jp3141/60Hz/60Hz.jpg

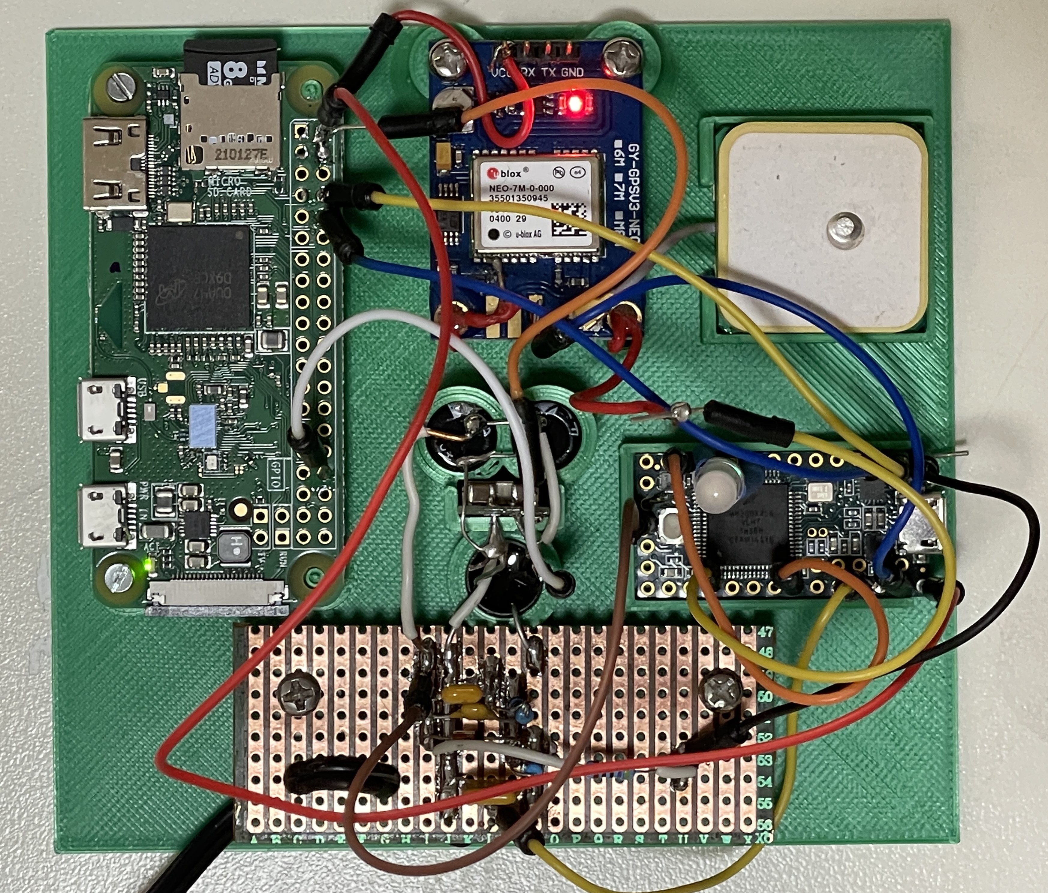
60Hz.jpg
