jp3141/60Hz/60 Hz Data 1 Month.png

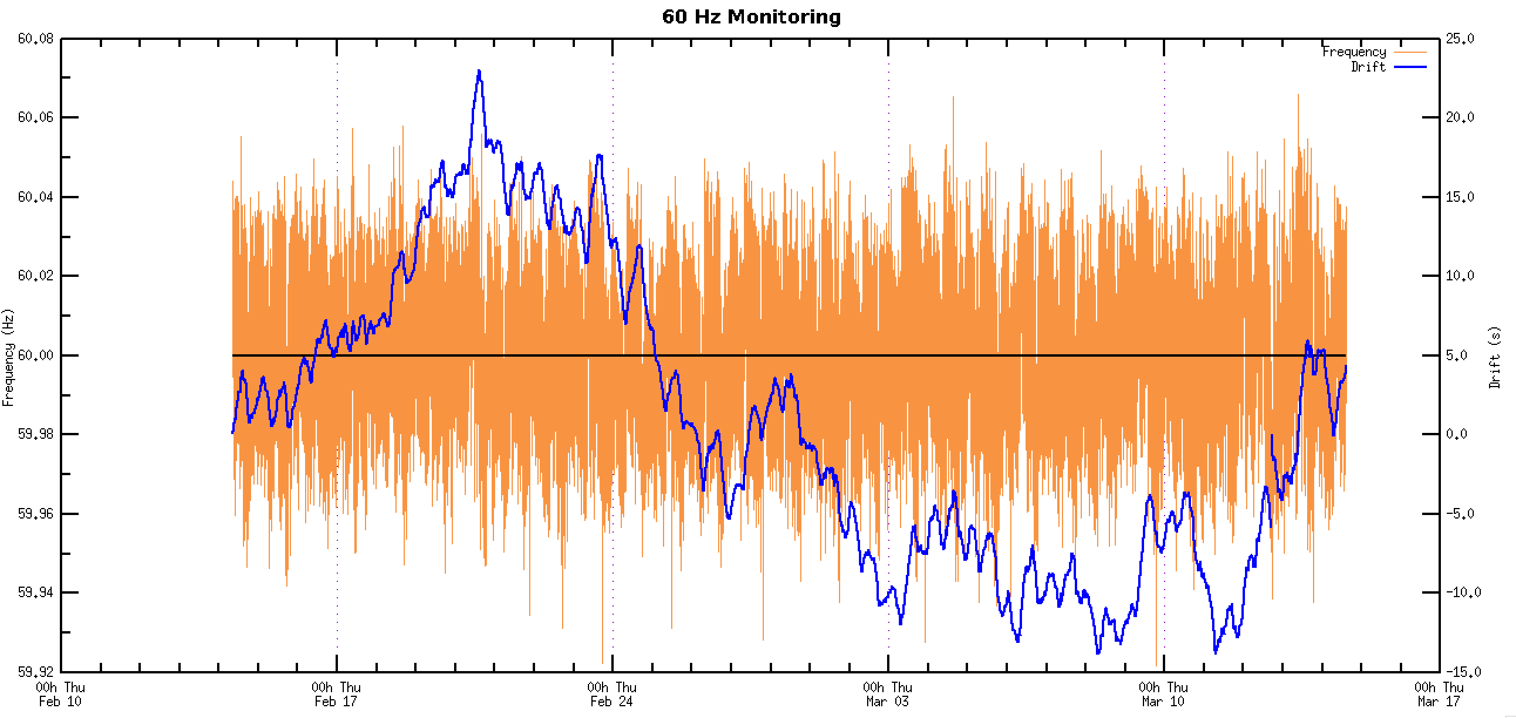
60 Hz Data 1 Month.png
