jp3141/60Hz/60 Hz Feb-Mar 2022.png

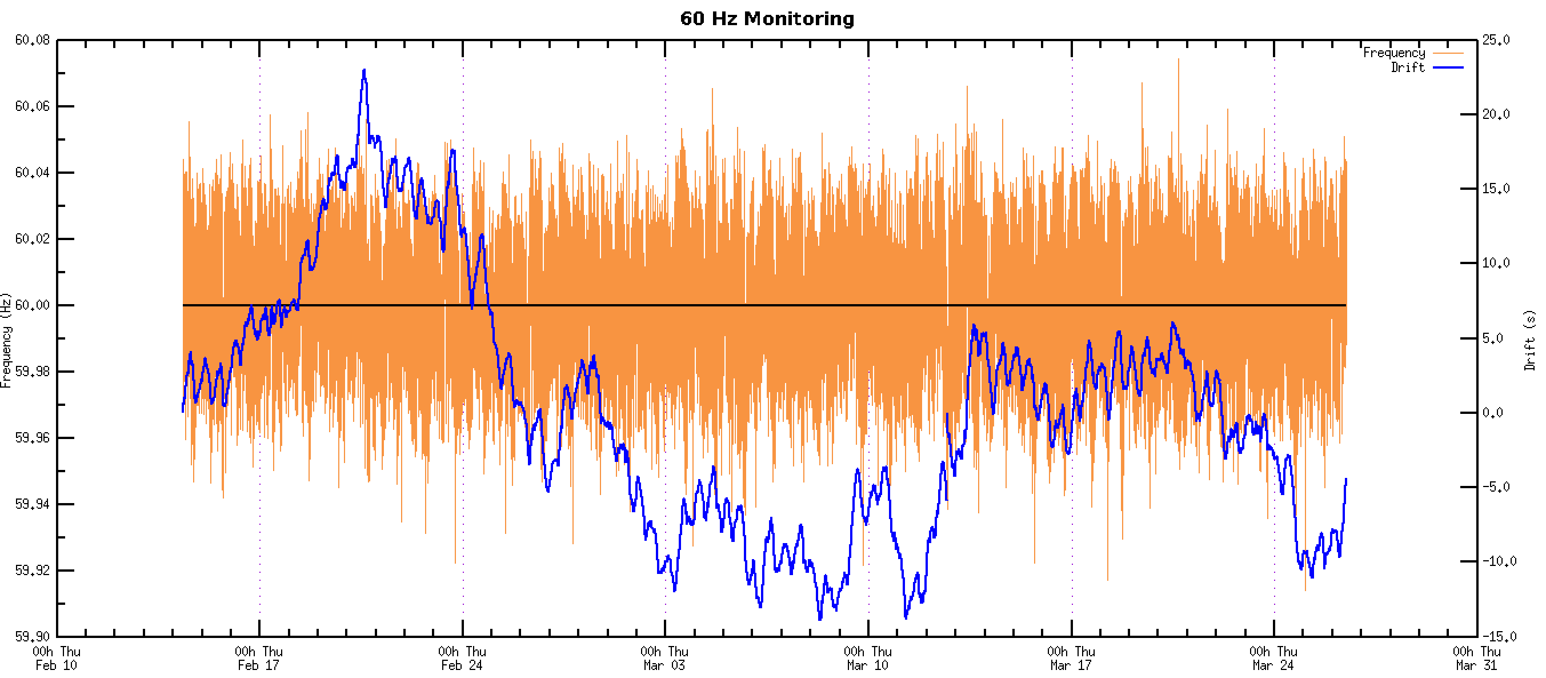
60 Hz Feb-Mar 2022.png
