jp3141/60Hz/60Hz.png

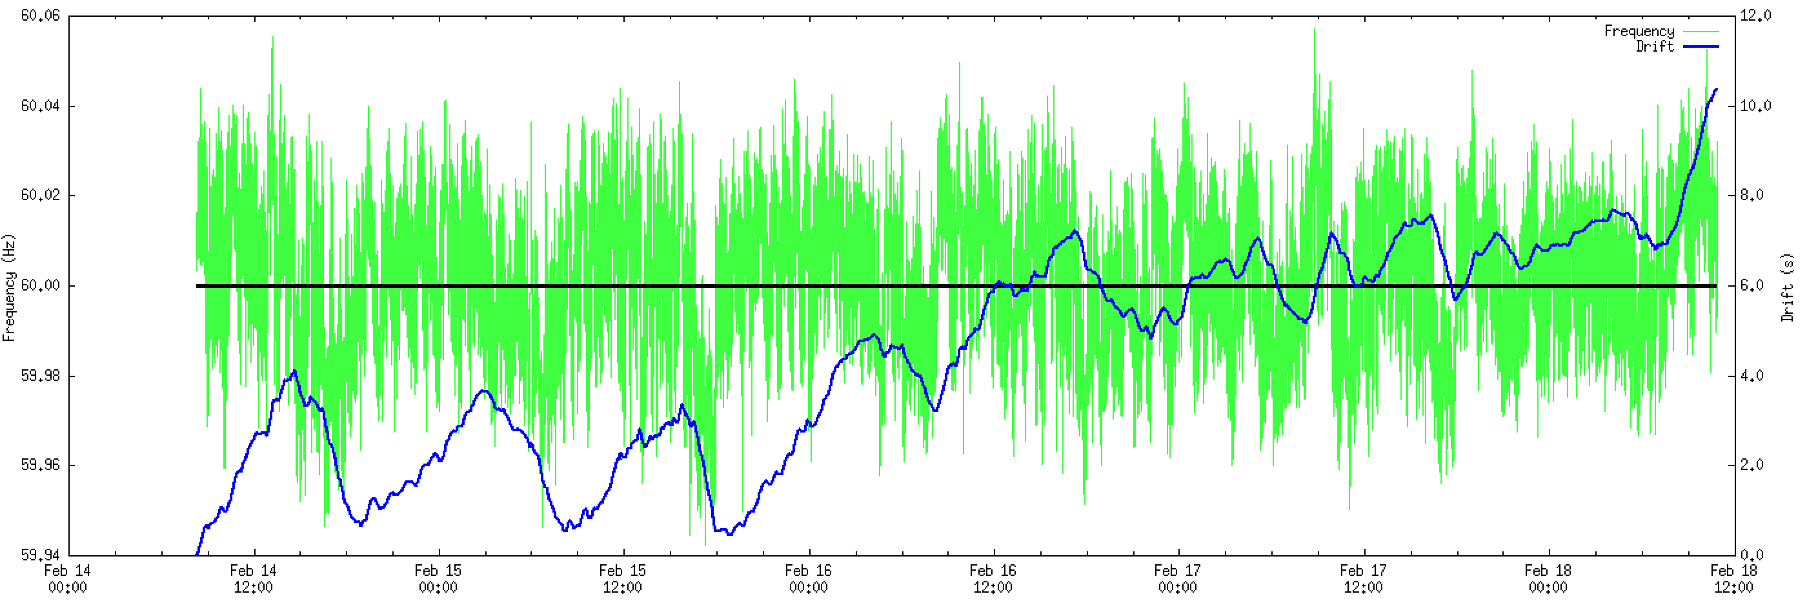
60Hz.png
