jp3141/60Hz/Average Frequency Feb-Mar 2022 vs. Time-of-Day.png

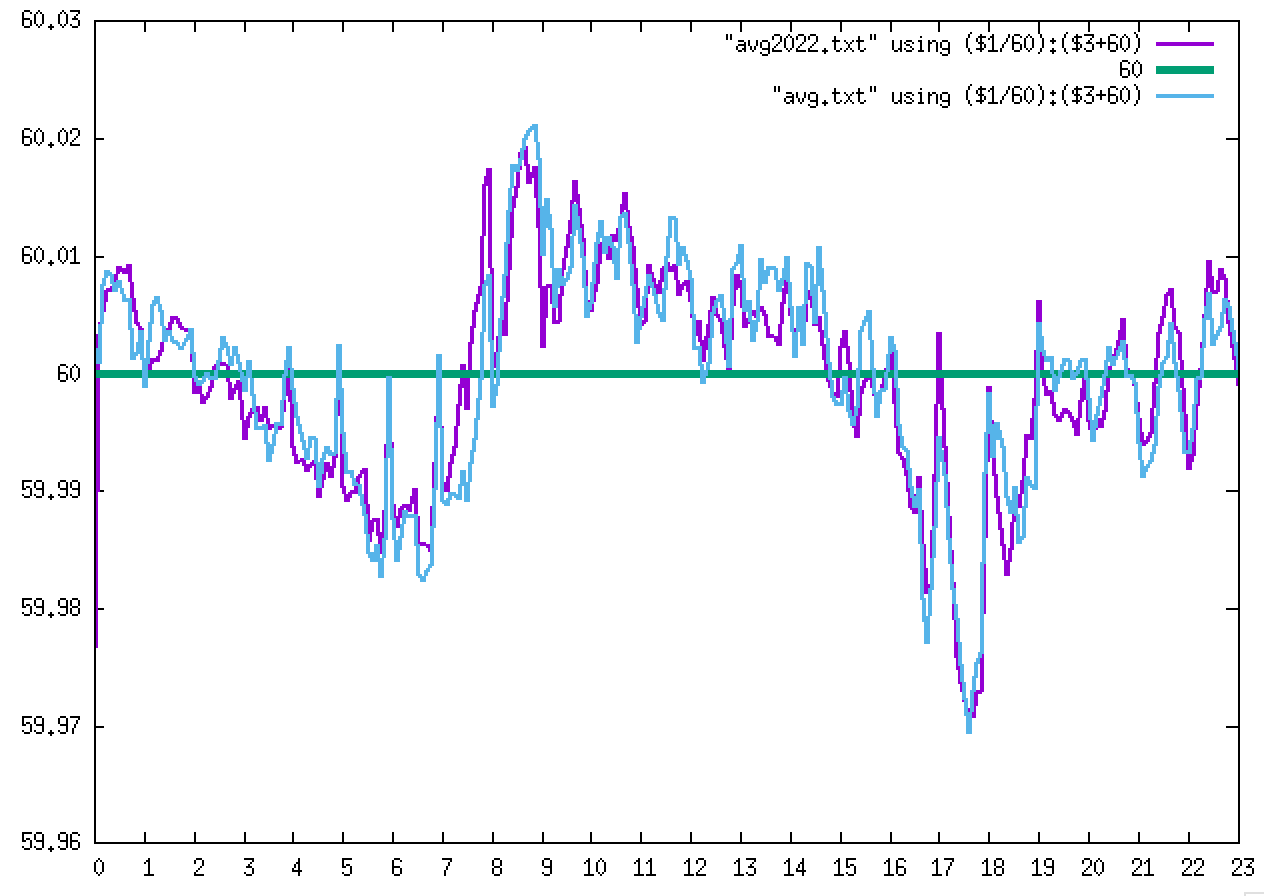
Average Frequency Feb-Mar 2022 vs. Time-of-Day.png
