jp3141/60Hz/Frequency vs Time of Day.png

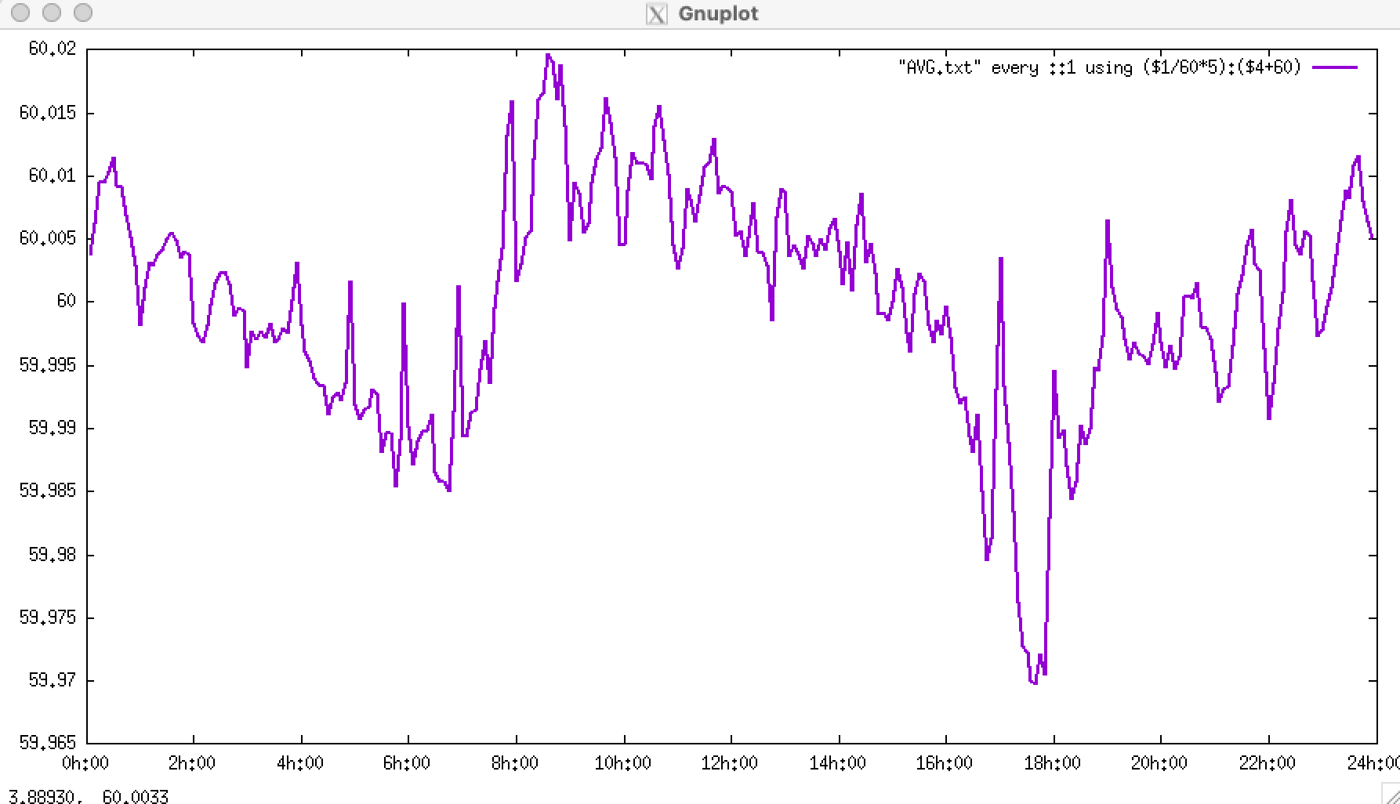
Frequency vs Time of Day.png
