jp3141/60Hz/Histogram Deviations Feb-Mar 2022.png

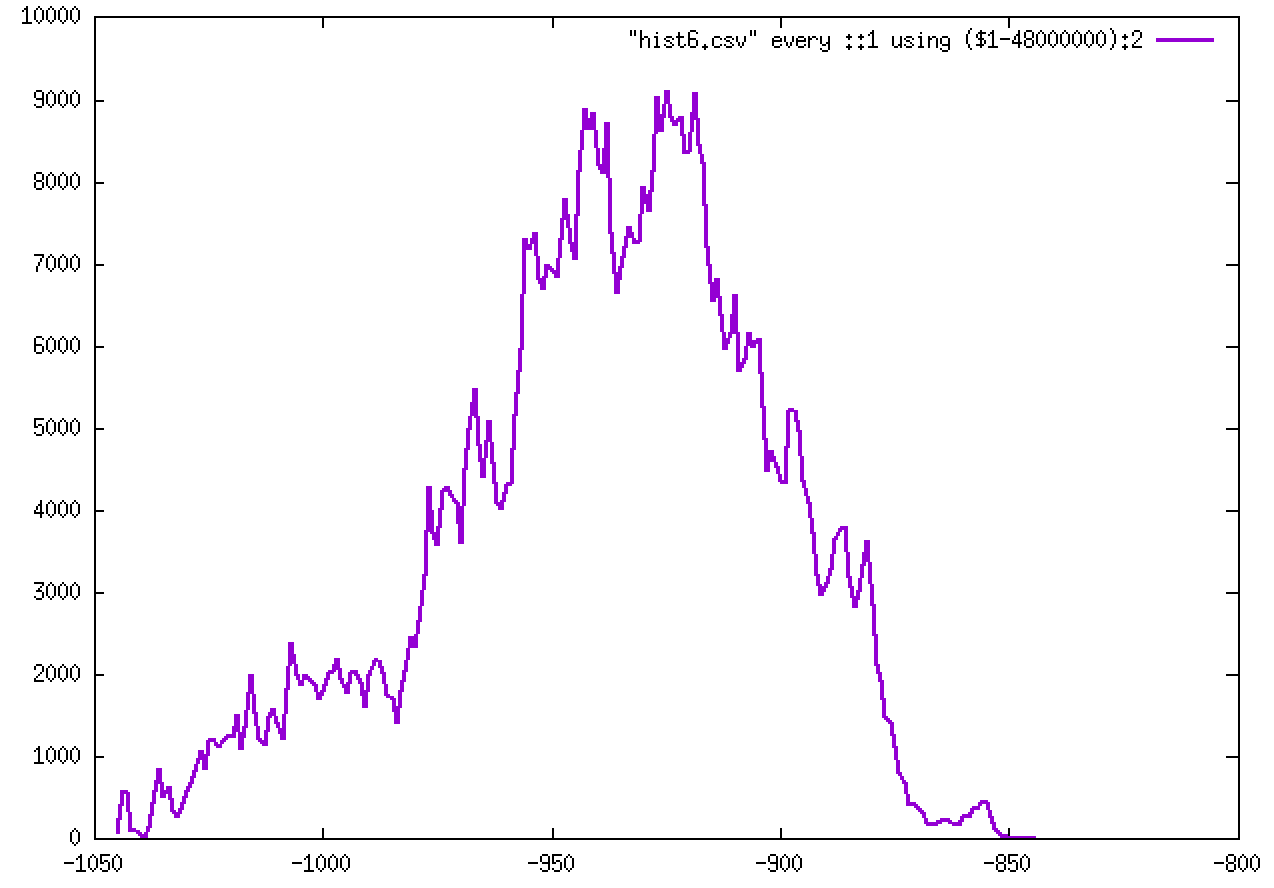
Histogram Deviations Feb-Mar 2022.png
