jp3141/60Hz/Histogram of Deviations from 48M.png

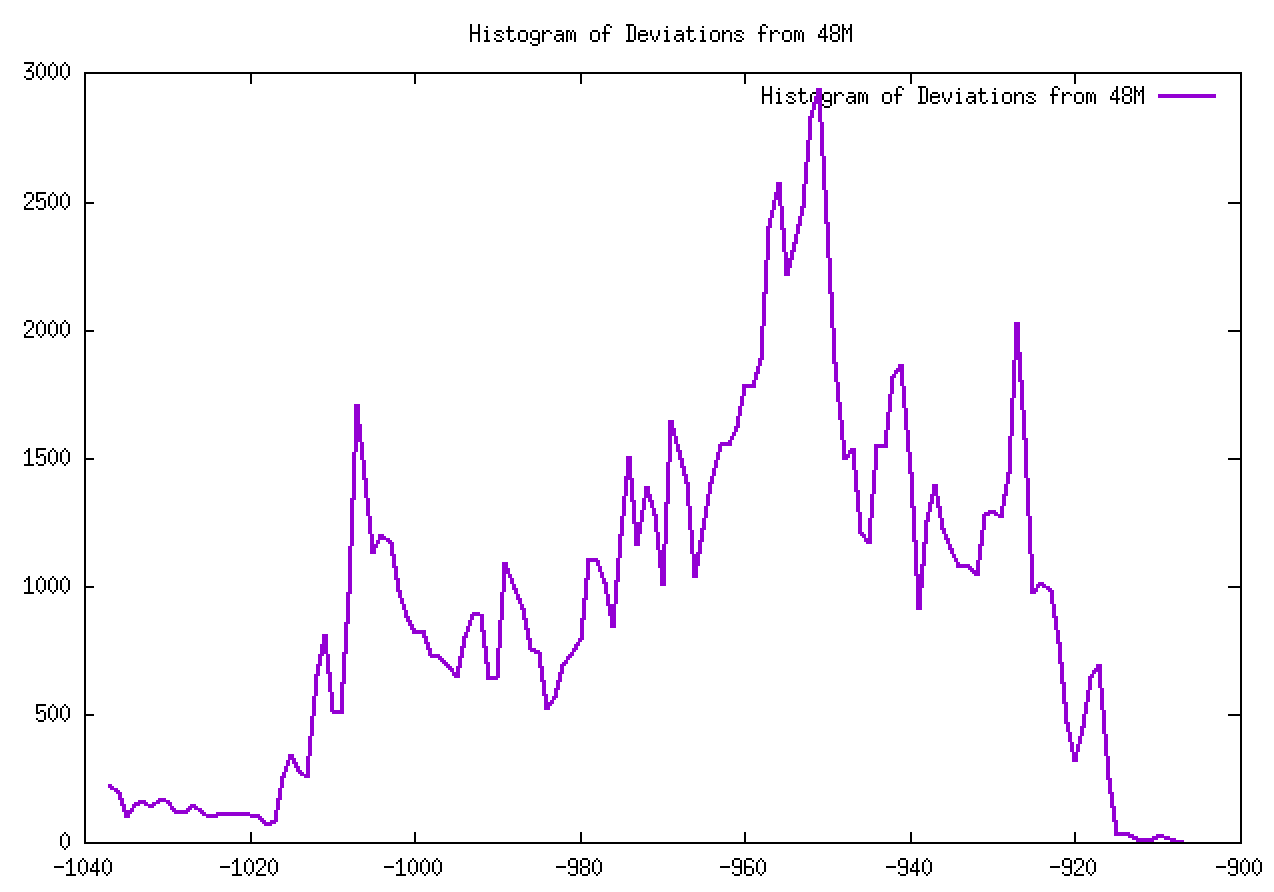
Histogram of Deviations from 48M.png
