jp3141/60Hz/(commit log)

2022-02-13 Teensy .ino
    Teensy Arduino code to count 60 Hz calibrated with 1 ups from GPS
2022-02-20 Phase overflow
    User ARM internal cycle counter instead of elapsedMicros() because of incorrect behaviour during coincident interrupts
2022-02-21 Add files via upload
    deviations of '48M' -- either Teensy XTAL or 1 pps. Max is ~ +/- 1 ppm
2022-03-26 histogram 6 weeks
    awk -F, '{print $5}' 60Hz.log|awk '{a=$1+0;ARRAY[a]++}END{for (INDEX in ARRAY) printf("%9i, %9i\n", INDEX, ARRAY[INDEX])}'|sort -u|less > hist.csv
    plot "hist6.csv" every ::1 using ($1-48000000):2 with lines lw 2
2022-03-26 Avg vs. time of day 2022
    awk -F"[ :,]+" '!/#/{Submin=$2*60+int($3/5)*5; Freq[Submin]+=$7-60; FreqCount[Submin]++}END{for (i=0; i<24*60; i+=5)printf("%4i %02i:%02i %12.9f\n", i, int(i/60), i % 60, Freq[i]/FreqCount[i])}' 60Hz.log|less
    plot "avg.txt" using ($1/60):($3+60) with lines lw 2, 60 lw 4
